Extraordinary-L/GelFin-for-ORCA-Hand-V1/GelFIn CAD Files/GelFin Assembled.STEP

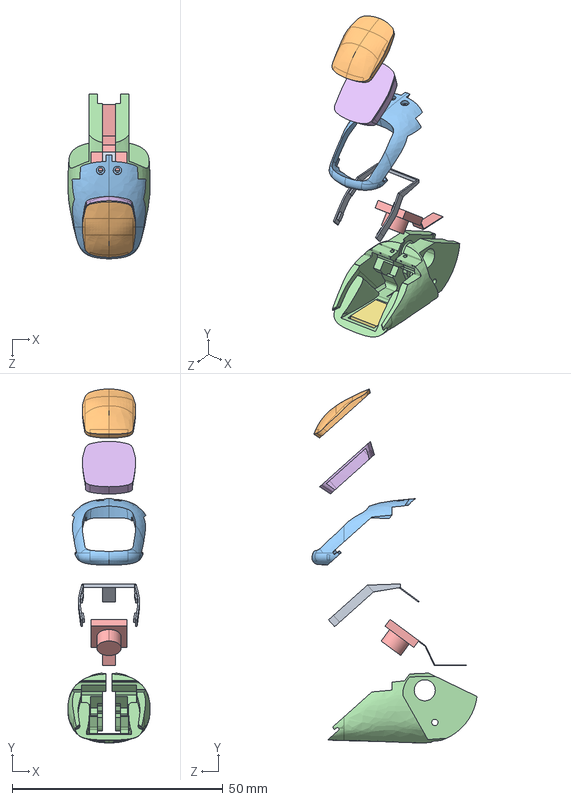
[picture p4: CAD file, 2026-10-12]
GelFIn CAD Files/GelFin Assembled.STEP
19.6 x 84.1 x 39.2 mm
灯带
硅胶
外壳上半部分
外壳下半部分
相机
亚克力
镜子1
