Extraordinary-L/GelFin-for-ORCA-Hand-V1/(commit log)

2026-10-12 add Fabrication and Assembly Guide
2026-10-12 add BOM
2026-10-12 Add CAD Files
    [GelFin Assembled.STEP]
2026-10-13 Modify BOM
